terroiblea/Gustavo-lita-/README.md

# Gustavo-lita

Dispensador interactivo en forma de monstruo de color verde que reacciona emocionalmente según el color del chicle detectado. Como cada color significa una emoción, al momento de girar la manilla para obtener tu chicle, el monstruo te dará tu suerte del día (mensaje), acompañado de una animación y un audio correspondiente a la emoción/color del chicle. 

https://github.com/user-attachments/assets/58932567-9fe7-45b8-b389-26f1e87cae60

## Equipo terrícola. 

- Catalina Catalán.
- Valentina Chávez.
- Camila Delgado.
- Nicolás Miranda.
- Miguel Vera.

# Objetivo del Proyecto. 

- Crear una experiencia lúdica e interactiva que vincule colores, emociones y tecnología.
- Mostrar cómo los sensores y actuadores pueden combinarse para generar una **respuesta audiovisual emocional**.

## Descripción general del funcionamiento. 

Consiste en un dispensador de chicles con cuatro colores:

| Colores | Significado |
|---|---|
| 🔴 Rojo | Enojado |
| 🟠 Naranjo | Loco |
| 🟢 Verde | Feliz |
| 🔵 Azul  | Triste |

- Cada vez que cae un chicle, el sensor identifica su tono.
- El monstruo reacciona mostrando una animación del ojo en una pantalla circular y reproduciendo un audio a la emoción detectada.

## Interacción. 

1. El usuario gira la manilla para que caiga un chicle.
2. El chicle pasa por el sensor de color.
3. El sensor detecta el color dominante.
4. El sistema identifica la emoción asociada.
5. El ojo del monstruo cambia su animación según la emoción.
6. Se reproduce el sonido correspondiente desde el módulo MP3.
7. El proceso se repite con cada chicle.

## Componentes utilizados. 

- Arduino Uno R3.
- Arduino UNo R4 minima. 
- Sensor de Color TCS3200 / TCS230.
- Pantalla TFT Circular 1.24 pulgadas.
- Módulo MP3.
- Conversor Lógico de Voltaje.
- Memoria MicroSD.
- Altavoz mini speaker.
- Cables.
- Protoboard.
- Fuente de alimentación.
