terroiblea/Gustavo-lita-/Codigo/pantallaFinalR3.ino

//Código correspondiente a arduino R3
//únicazmente ligado a pantalla, funciona recibiendo señal del arduino R4
//este indica cuando prender y apagar la pantalla

//Bibliotecas de la pantalla
#include <Adafruit_GFX.h>
#include <Adafruit_GC9A01A.h>
#include <SPI.h>

// Pines (ajusta según tu conexión)
#define TFT_CS   10
#define TFT_DC   9
#define TFT_RST  8
#define SIGNAL_PIN A5 
// Pin analógico que recibe la señal del R4

Adafruit_GC9A01A tft(TFT_CS, TFT_DC, TFT_RST);

// Booleano para saber si la imagen ya se dibujó
bool imagenMostrada = false;

// Imagen en blanco y negro (pega tu array aquí)
const unsigned char epd_bitmap_Mesa_de_trabajo_1jjj [] PROGMEM = {
	0x00, 0x00, 0x00, 0x00, 0x00, 0x00, 0x00, 0x00, 0x00, 0x00, 0x00, 0x00, 0x00, 0x00, 0x00, 0x00, 
	0x00, 0x00, 0x00, 0x00, 0x00, 0x00, 0x00, 0x00, 0x00, 0x00, 0x00, 0x00, 0x00, 0x00, 0x00, 0x00, 
	0x00, 0x00, 0x00, 0x00, 0x00, 0x00, 0x00, 0x00, 0x00, 0x00, 0x00, 0x00, 0x00, 0x00, 0x00, 0x00, 
	0x00, 0x00, 0x00, 0x00, 0x00, 0x00, 0x00, 0x00, 0x00, 0x00, 0x00, 0x00, 0x00, 0x00, 0x00, 0x00, 
	0x00, 0x00, 0x00, 0x00, 0x00, 0x00, 0x00, 0x00, 0x00, 0x00, 0x00, 0x00, 0x00, 0x00, 0x00, 0x00, 
	0x00, 0x00, 0x00, 0x00, 0x00, 0x00, 0x00, 0x00, 0x00, 0x00, 0x00, 0x00, 0x00, 0x00, 0x00, 0x00, 
	0x00, 0x00, 0x00, 0x00, 0x00, 0x00, 0x00, 0x00, 0x00, 0x00, 0x00, 0x00, 0x00, 0x00, 0x00, 0x00, 
	0x00, 0x00, 0x00, 0x00, 0x00, 0x00, 0x00, 0x00, 0x00, 0x00, 0x00, 0x00, 0x00, 0x00, 0x00, 0x00, 
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
    imagenMostrada = true;
  } 
  // Si recibe señal LOW limpia la pantalla
  else if (estado == LOW && imagenMostrada) {
    Serial.println("Señal apagada: limpiando pantalla");
    tft.fillScreen(GC9A01A_BLACK);
    imagenMostrada = false;
  }

  delay(50); 
	// pequeño retardo para que no se trabe
}
