terroiblea/Gustavo-lita-/Imagenes/Juntos.jpg

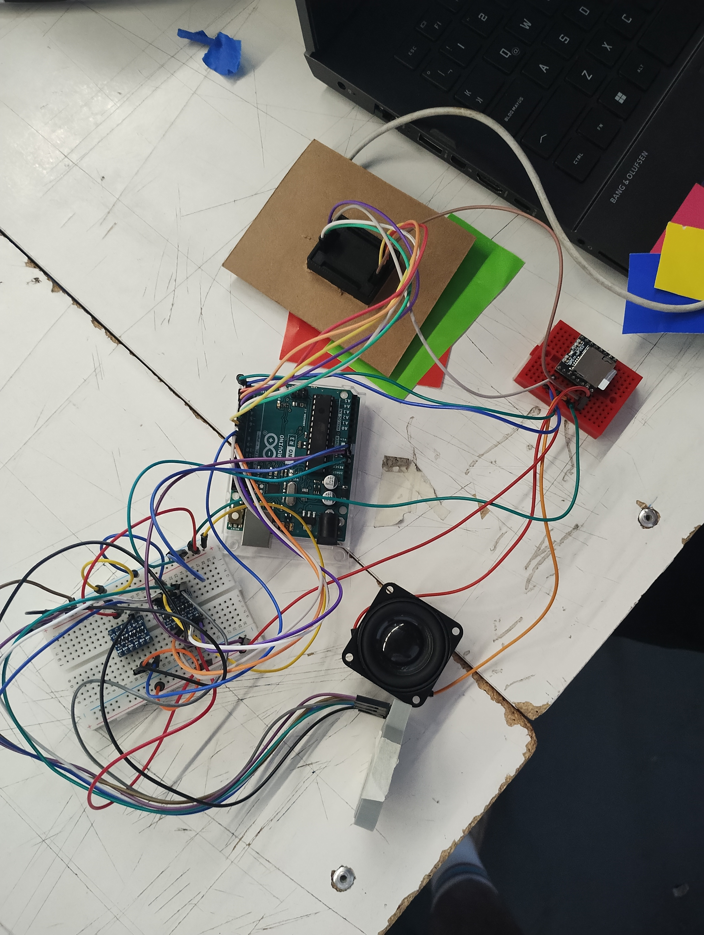
[picture p21: Proyecto/Imagenes/Juntos.jpg]
Imagenes/Juntos.jpg
